ORI2333/Water-meter-quality-inspection/docs/FPGA_ISP_RK3588_WaterMeter_User_Manual.md

# FPGA ISP 涓? RK3588 姘磋〃妫?娴嬩娇鐢ㄦ墜鍐?

鐗堟湰锛歏1.2

鏃ユ湡锛?2026-07-07

## 1. 浣跨敤鑼冨洿

鏈枃妗ｇ敤浜庢寚瀵肩幇鍦鸿繍琛屼互涓嬮摼璺細

```text
SC1336 DVP 鐩告満 -> FPGA ISP -> HDMI 杈撳嚭 -> RK3588 HDMI 閲囬泦 -> YOLO11-pose 鎸囬拡妫?娴?
```

閫傜敤璺緞锛?

| 椤圭洰 | 璺緞 |
| --- | --- |
| FPGA 宸ョ▼ | `fpga/sc1336_hdmi_isp` |
| FPGA 椤跺眰 | `rtl/sc1336_hdmi.sv` |
| FPGA 宸ョ▼鏂囦欢 | `prj/sc1336_hdmi.xpr` |
| RK 浠ｇ爜鐩綍 | `/home/demo/water_meter/code` |
| RK Web 鍚姩鑴氭湰 | `/home/demo/water_meter/run_hdmi_yolo11_pose_web.sh` |
| RK 榛樿妯″瀷 | `/home/demo/water_meter/module/water_meter_yolo11n_pose_fp.rknn` |
| RK 蹇?熸ā鍨? | `/home/demo/water_meter/module/int8_variants/water_meter_yolo11n_pose_int8_headrs_float_normal.rknn` |
| RK Web 椤甸潰 | `http://<RK3588-IP>:6008/` |

## 2. 鍑嗗宸ヤ綔

### 2.1 纭欢杩炴帴

璇风‘璁わ細

1. SC1336 DVP 鐩告満宸茶繛鎺? FPGA銆?
2. FPGA HDMI 杈撳嚭宸茶繛鎺ュ埌 RK3588 HDMI 閲囬泦杈撳叆銆?
3. FPGA UART 璋冭瘯鍙ｅ凡杩炴帴鍒扮數鑴戜覆鍙ｅ伐鍏枫??
4. RK3588 宸插紑鏈猴紝骞惰兘閫氳繃 SSH 璁块棶銆?
5. 鎺ㄨ崘浣跨敤 RK3588 鏈湴 Web 椤甸潰鏄剧ず妫?娴嬬粨鏋滐紝涓嶅啀渚濊禆 Qt 妗岄潰绐楀彛銆?

### 2.2 涓插彛鍙傛暟

FPGA UART 鍙傛暟锛?

| 鍙傛暟 | 鍊? |
| --- | --- |
| 娉㈢壒鐜? | 115200 |
| 鏁版嵁浣? | 8 |
| 鏍￠獙浣? | None |
| 鍋滄浣? | 1 |
| 娴佹帶 | None |

涓插彛宸ュ叿鍙互浣跨敤 MobaXterm銆乆COM銆丼ecureCRT銆丳uTTY 鎴栧叾浠栦覆鍙ｅ姪鎵嬨??

寤鸿涓插彛宸ュ叿鍏抽棴鑷姩杩藉姞鎹㈣锛屽彧鍙戦?佸崟涓瓧绗﹀懡浠ゃ??

### 2.3 RK3588 SSH

榛樿杩炴帴淇℃伅锛?

```bash
ssh root@<RK3588-IP>
```

瀵嗙爜璇蜂娇鐢ㄧ幇鍦鸿澶囧疄闄呴厤缃紝涓嶅缓璁啓鍏ュ叕寮?浠撳簱銆?

## 3. FPGA 宸ョ▼缂栬瘧涓庝笅杞?

### 3.1 鎵撳紑宸ョ▼

Vivado 宸ョ▼鏂囦欢锛?

```text
fpga/sc1336_hdmi_isp\prj\sc1336_hdmi.xpr
```

### 3.2 寤鸿娴佺▼

1. 鎵撳紑 Vivado 宸ョ▼銆?
2. 杩愯缁煎悎銆?
3. 杩愯瀹炵幇銆?
4. 妫?鏌? timing summary銆?
5. 鐢熸垚 bitstream銆?
6. 涓嬭浇鍒? FPGA銆?

濡傛灉瀹炵幇闃舵鍑虹幇 `[Timing 38-282]`锛岄渶瑕佹墦寮? timing summary 鏌ョ湅鍏蜂綋杩濅緥璺緞銆傝嫢涓昏杩濅緥鏉ヨ嚜 ILA銆佽法鏃堕挓璋冭瘯淇″彿鎴栧凡鏈夌害鏉熼棶棰橈紝鐭湡涓婃澘楠岃瘉鍙厛鐪嬪疄闄呯敾闈紱鑻ヨ繚渚嬫潵鑷? HDMI 鍍忕礌閾捐矾銆丏DR 鐢ㄦ埛鎺ュ彛鎴栨柊 ISP 涔樻硶閾捐矾锛屽垯闇?瑕佷紭鍏堝鐞嗐??

褰撳墠鐧藉钩琛′箻娉曞凡缁忓仛杩囨祦姘寸嚎澶勭悊锛岀悊璁轰笂姣旂粍鍚堢骇鑱斾箻娉曟洿瀹规槗杩囨椂搴忋??

## 4. FPGA 鏄剧ず妯″紡娴嬭瘯

涓婃澘鍚庡缓璁寜浠ヤ笅椤哄簭娴嬭瘯銆?

### 4.1 LCD/HDMI 鍩虹娴嬭瘯

鍙戦?侊細

```text
L
```

棰勬湡鐜拌薄锛?

- HDMI 杈撳嚭娴嬭瘯鍥俱??
- 濡傛灉 `L` 閮芥病鏈夋甯告樉绀猴紝浼樺厛妫?鏌? HDMI 杈撳嚭銆佹椂閽熴?佸紩鑴氱害鏉熴?丷K 閲囬泦鑴氭湰銆?

### 4.2 DDR 鍔ㄦ?佹祴璇?

鍙戦?侊細

```text
D
```

棰勬湡鐜拌薄锛?

- 鐢婚潰缁忚繃 DDR 鍐欏叆鍜岃鍑恒??
- 搴旇鑳界湅鍒板姩鎬佹祴璇曞浘銆?
- 鑻? `L` 姝ｅ父鑰? `D` 寮傚父锛屼紭鍏堟鏌? DDR 鍒濆鍖栥?丄XI4銆佸抚缂撳瓨璇诲啓銆?

### 4.3 浼犳劅鍣? RAW 鐏板害

鍙戦?侊細

```text
R
```

鎴栵細

```text
S
```

棰勬湡鐜拌薄锛?

- 鏄剧ず鐩告満 RAW 鐏板害鐢婚潰銆?
- 鐢婚潰鍙兘鍋忕伆銆佹棤褰╄壊锛岃繖鏄甯哥幇璞°??
- 鑻ユ棤鐢婚潰锛屾鏌? SC1336 I2C 鍒濆鍖栥?丏VP PCLK銆乂SYNC銆丠REF銆丏ATA銆?

### 4.4 RGB 鍘婚┈璧涘厠

鍙戦?侊細

```text
I
```

棰勬湡鐜拌薄锛?

- 鍑虹幇褰╄壊鐢婚潰銆?
- 濡傛灉棰滆壊鏄庢樉閿欎贡锛屽彲灏濊瘯 Bayer 鐩镐綅鍛戒护銆?

Bayer 鐩镐綅鍛戒护锛?

```text
0
1
2
3
```

渚濇灏濊瘯锛岄?夋嫨棰滆壊鏈?鑷劧銆佽竟缂樹吉褰╂渶灏戠殑涓?妗ｃ??

### 4.5 鐧藉钩琛′笌浜害

鍙戦?侊細

```text
W
```

棰勬湡鐜拌薄锛?

- 寮?鍚? RGB 鐧藉钩琛°?佸叏灞?澧炵泭鍜屼寒搴﹀亸缃??
- 褰撳墠榛樿鐢婚潰浼氭瘮绾? `I` 妯″紡鏇翠寒銆?

濡傛灉鍚庣画瑕佺敤浜? RK 姘磋〃妫?娴嬶紝鎺ㄨ崘浣跨敤锛?

```text
C
```

`C` 妯″紡鍦? `W` 鍩虹涓婂姞浜嗚竟鐣岃鍓紝鏇撮?傚悎浣滀负褰撳墠闃舵鐨勫僵鑹茶緭鍑哄熀绾裤??

## 5. 涓插彛璋冨弬鍛戒护

### 5.1 妯″紡鍛戒护

| 鍛戒护 | 浣滅敤 |
| --- | --- |
| `L` | LCD/HDMI 娴嬭瘯鍥撅紝缁曡繃 DDR |
| `D` | DDR 鍔ㄦ?佹祴璇曞浘 |
| `X` | DDR 闈欐?? XOR 娴嬭瘯鍥? |
| `G` | DDR 鍥哄畾鐏板害娴嬭瘯鍥? |
| `S` / `R` | 鐩告満 RAW 鐏板害 |
| `I` | RAW 杞? RGB锛屼笉鍔犵櫧骞宠　 |
| `W` | RGB + 鍙皟鐧藉钩琛?/浜害 |
| `C` | RGB + 鍙皟鐧藉钩琛?/浜害 + crop |
| `0` `1` `2` `3` | Bayer 鐩镐綅鍒囨崲 |

### 5.2 鐧藉钩琛′笌浜害鍛戒护

| 鍛戒护 | 浣滅敤 |
| --- | --- |
| `r` | 绾㈣壊澧炵泭澧炲姞 |
| `f` | 绾㈣壊澧炵泭鍑忓皯 |
| `g` | 缁胯壊澧炵泭澧炲姞 |
| `v` | 缁胯壊澧炵泭鍑忓皯 |
| `b` | 钃濊壊澧炵泭澧炲姞 |
| `n` | 钃濊壊澧炵泭鍑忓皯 |
| `a` | 鍏ㄥ眬澧炵泭澧炲姞 |
| `z` | 鍏ㄥ眬澧炵泭鍑忓皯 |
| `+` | 浜害鍋忕疆澧炲姞 |
| `-` | 浜害鍋忕疆鍑忓皯 |
| `w` | 鎭㈠榛樿鐧藉钩琛″拰浜害 |

娉ㄦ剰澶у皬鍐欙細

- `W`锛氳繘鍏ョ櫧骞宠　鏄剧ず妯″紡銆?
- `w`锛氭仮澶嶉粯璁よ皟鍙傚?笺??

## 6. 鎺ㄨ崘璋冨弬娴佺▼

### 6.1 姝ｅ父鍏夌収

1. 鍙戦?? `C`锛岃繘鍏ユ帹鑽愬僵鑹茶緭鍑烘ā寮忋??
2. 濡傛灉鏁翠綋鍋忔殫锛屽厛鍙戦?? `a`锛屾瘡娆″鍔犵害 0.0625x 鍏ㄥ眬澧炵泭銆?
3. 濡傛灉鍙兂鎶珮鏆楅儴锛屽彲鍙戦?? `+` 澧炲姞浜害鍋忕疆銆?
4. 濡傛灉鐢婚潰鍋忕孩锛屽彂閫? `f` 闄嶄綆绾㈣壊澧炵泭銆?
5. 濡傛灉鐢婚潰鍋忚摑锛屽彂閫? `n` 闄嶄綆钃濊壊澧炵泭銆?
6. 濡傛灉鐢婚潰鍋忕豢锛屽彂閫? `v` 闄嶄綆缁胯壊澧炵泭銆?
7. 濡傛灉璋冧贡锛屽彂閫? `w` 鎭㈠榛樿銆?

### 6.2 鏆楀厜鍦烘櫙

鎺ㄨ崘椤哄簭锛?

1. 淇濇寔鏇濆厜闄愬埗锛屼笉寤鸿鐩存帴鏀惧紑闀挎洕鍏夈??
2. 鍏堢敤 `a` 鎻愰珮鍏ㄥ眬澧炵泭銆?
3. 鍐嶇敤 `+` 灏戦噺鎻愰珮浜害鍋忕疆銆?
4. 濡傛灉琛ㄧ洏鐧藉簳杩囨洕锛屽彂閫? `z` 鎴? `-` 鍥為??銆?
5. 蹇呰鏃跺鍔犲閮ㄨˉ鍏夈??

鍒ゆ柇鏍囧噯锛?

- 姘磋〃鍒诲害杈圭紭娓呮櫚銆?
- 鎸囬拡鍜岃儗鏅湁鏄庢樉瀵规瘮銆?
- 鐧藉簳涓嶈繃鏇濇垚涓?鐗囥??
- 鐢婚潰娌℃湁鏄庢樉鎷栧奖鍜屽欢鏃躲??

### 6.3 鐢ㄤ簬 YOLO 妫?娴嬬殑鐢婚潰鏍囧噯

涓嶈鍙寜鑲夌溂鈥滀寒涓嶄寒鈥濆垽鏂?傜敤浜庢娴嬫椂鏇撮噸瑕佺殑鏄細

1. 鎸囬拡灏栫杈圭紭娓呮銆?
2. 灏忚〃鐩樺埢搴﹀拰鎸囬拡鏈夌ǔ瀹氬姣斻??
3. 琛ㄧ洏鍖哄煙涓嶈繃鏇濄??
4. 鏆楅儴鍣０涓嶈杩囬珮銆?
5. 鐢婚潰寤惰繜涓嶈鏄庢樉澧炲姞銆?

## 7. RK3588 Web 妫?娴嬭繍琛?

### 7.1 鍚姩 Web 妫?娴嬫湇鍔?

鍦? RK3588 涓婃墽琛岋細

```bash
cd /home/demo/water_meter
./run_hdmi_yolo11_pose_web.sh
```

鐢佃剳娴忚鍣ㄦ墦寮?锛?

```text
http://<RK3588-IP>:6008/
```

濡傛灉闇?瑕佽皟瑙掑害绋冲畾鍙傛暟锛?

```bash
./run_hdmi_yolo11_pose_web.sh --angle-deadband 3.0 --angle-alpha 0.20 --angle-confirm-frames 4 --turn-deadband 4.0
```

鍙傛暟璇存槑锛?

| 鍙傛暟 | 榛樿鍊? | 浣滅敤 |
| --- | --- | --- |
| `--angle-deadband` | 3.0 | 灏忎簬璇ヨ搴﹀彉鍖栦笉鍒锋柊鏄剧ず |
| `--angle-alpha` | 0.20 | 瓒呰繃姝诲尯鍚庣殑骞虫粦鏇存柊姣斾緥 |
| `--angle-confirm-frames` | 4 | 杩炵画澶氬抚纭鍚庢墠鎺ュ彈瑙掑害鍙樺寲 |
| `--turn-deadband` | 4.0 | 瓒呰繃璇ヨ搴﹀彉鍖栨墠璁″叆绱鍦堟暟 |

璋冨弬寤鸿锛?

| 鐜拌薄 | 璋冩暣 |
| --- | --- |
| 闈欐?佽搴︿粛杞诲井璺冲姩 | 澧炲ぇ `--angle-deadband` 鎴? `--angle-confirm-frames` |
| 鎸囬拡绾垮弽搴斿お鎱? | 澧炲ぇ `--angle-alpha`锛屾垨闄嶄綆 `--angle-confirm-frames` |
| 鍦堟暟闈欐?佹紓绉? | 澧炲ぇ `--turn-deadband` |

### 7.2 Web 椤甸潰鎿嶄綔璇存槑

褰撳墠鎺ㄨ崘浣跨敤鏈湴 Web 椤甸潰锛屼笉鍐嶄娇鐢? Qt 绐楀彛銆傞〉闈㈠湴鍧?锛?

```text
http://<RK3588-IP>:6008/
```

椤甸潰甯冨眬锛?

| 鍖哄煙 | 浣滅敤 |
| --- | --- |
| 宸︿晶瑙嗛鍖? | 鏄剧ず FPGA HDMI 瀹炴椂鐢婚潰鍜屾娴嬭鐩栧眰 |
| 瑙嗛涓嬫柟鍔熻兘鍖? | 鏆傚仠銆佸埛鏂般?佹埅鍥俱?佹樉绀?/闅愯棌鏍囨敞銆佹ā鍨嬫ā寮忓垏鎹€?佽棰戝ぇ灏忋?佹帹娴佹竻鏅板害 |
| 鍙充晶淇℃伅鏍? | 涓ゅ垪鏄剧ず鏍″噯銆佹ā鍨嬭緭鍏ャ?佸洓涓〃鐩樿搴︺?佸湀鏁般?佺粡杩囨按閲忎及绠椼?佹帴鍙ｄ俊鎭? |

瑙嗛鍖哄煙鍐呭彧淇濈暀鐭爣绛撅紝渚嬪 `10^-1`銆乣10^-2`銆傚師濮嬭搴︺?佺ǔ瀹氳搴︺?佸湀鏁般?佹瘡鍦堟按閲忋?佹湰琛ㄤ及绠楁按閲忕瓑璇︾粏鏁版嵁鏀惧湪鍙充晶鈥滆〃鐩樻娴嬪垪琛ㄢ?濅腑锛岄伩鍏嶆枃瀛楅伄鎸℃按琛ㄧ洰鏍囥??

甯哥敤鎸夐挳锛?

| 鎺т欢 | 浣滅敤 |
| --- | --- |
| 鏆傚仠 / 缁х画 | 鏆傚仠鎴栨仮澶? HDMI 閲囬泦鍜屾帹鐞? |
| 鍒锋柊瑙嗛 | 閲嶆柊鎵撳紑 MJPEG 瑙嗛娴? |
| 鎵撳紑鎴浘 | 鎵撳紑褰撳墠 Web 杈撳嚭甯? |
| 鏄剧ず妫?娴嬫爣娉? | 鎺у埗妫?娴嬫銆佷腑蹇冪偣銆佹寚閽堢嚎鍜岀煭鏍囩鏄惁鍙犲姞鍒拌棰? |
| 绮惧害 FP | 鍒囨崲鍒版诞鐐? RKNN 妯″瀷锛屽叧閿偣鏇村噯锛屽抚鐜囪緝浣? |
| 蹇?? INT8 | 鍒囨崲鍒? INT8 hybrid 妯″瀷锛屽抚鐜囨洿楂橈紝鍏抽敭鐐圭簿搴﹀彲鑳戒笅闄? |
| 灏忕獥 / 涓獥 / 褰遍櫌 | 蹇?熻皟鏁磋棰戞樉绀哄尯鍩熷ぇ灏? |

鐢昏川鍜岀爜鐜囨粦鏉★細

| 婊戞潯 | 浣滅敤 | 鏄惁褰卞搷 RK 璐熻浇 |
| --- | --- | --- |
| 瑙嗛妗嗗搴? | 鍙敼鍙樻祻瑙堝櫒涓棰戞鏄剧ず澶у皬 | 鍚? |
| 鎺ㄦ祦瀹藉害 | 鏀瑰彉 Web MJPEG 杈撳嚭瀹藉害 | 浼氬奖鍝嶇紪鐮佽礋杞藉拰缃戠粶娴侀噺 |
| JPEG 璐ㄩ噺 | 鏀瑰彉 MJPEG 鍘嬬缉璐ㄩ噺 | 浼氬奖鍝嶇紪鐮佽礋杞姐?佹竻鏅板害鍜岀爜鐜? |
| 缃戦〉甯х巼 | 鏀瑰彉 Web MJPEG 杈撳嚭甯х巼 | 浼氬奖鍝嶇紪鐮佽礋杞藉拰娴忚鍣ㄦ祦鐣呭害 |

寤鸿榛樿淇濇寔锛?

```text
鎺ㄦ祦瀹藉害 1280
JPEG 璐ㄩ噺 90
缃戦〉甯х巼 12 fps
```

濡傛灉 Web 绔欢杩熷ぇ鎴栫綉缁滀笉绋筹紝鍙紭鍏堥檷浣庣綉椤靛抚鐜囨垨鎺ㄦ祦瀹藉害锛涘鏋滃彧瑙夊緱鐢婚潰澶ぇ锛屼笉瑕侀檷浣庢帹娴佸搴︼紝鐩存帴璋冣?滆棰戞瀹藉害鈥濄??

### 7.3 姘撮噺璁＄畻閫昏緫

鍥涗釜灏忚〃鐩樻槸鍗佽繘鍒惰繘浣嶅叧绯伙紝涓嶈兘鎶婂洓涓〃鐩樼殑鐬椂瑙掑害鎴栧湀鏁扮洿鎺ョ浉鍔犮?傚綋鍓? Web 閲囩敤鈥滃紑濮嬫祴閲忔椂寤虹珛璧风偣锛屼箣鍚庢寜杩炵画杞璁＄畻缁忚繃姘撮噺鈥濈殑鏂瑰紡锛?

```text
鐐瑰嚮鈥滃紑濮嬫祴閲?/娓呴浂鈥?
    -> 娓呴浂鍚勮〃鐩樼疮璁″湀鏁?
    -> 涔嬪悗鎸佺画璺熻釜鎸囬拡瑙掑害鍙樺寲
    -> 鏈〃浼扮畻姘撮噺 = 绱鍦堟暟 x 姣忓湀姘撮噺
```

姣忎釜琛ㄧ洏鐨勬崲绠楀叧绯伙細

| 琛ㄧ洏 | 姣忓皬鏍? | 姣忓湀姘撮噺 |
| --- | --- | --- |
| `10^-1` | 0.1 m鲁 | 1.0 m鲁 |
| `10^-2` | 0.01 m鲁 | 0.1 m鲁 |
| `10^-3` | 0.001 m鲁 | 0.01 m鲁 |
| `10^-4` | 0.0001 m鲁 | 0.001 m鲁 |

褰撳墠椤甸潰涓绘樉绀衡?滄湰娆＄粡杩囨按閲忊?濋粯璁や娇鐢? `10^-4` 琛ㄧ洏浣滀负娴嬮噺鏉ユ簮锛屽洜涓哄畠鏈?鐏垫晱锛岄?傚悎鐭椂闂磋川妫?瑙傚療銆傚彸渚р?滆〃鐩樻娴嬪垪琛ㄢ?濅細鍚屾椂鏄剧ず鍥涗釜琛ㄧ洏鍚勮嚜浼扮畻鐨勬按閲忥紝鍚庣画鍙敤浜庝竴鑷存?ф鏌ャ??

鐜板満鎺ㄨ崘娴佺▼锛?

1. 闇?瑕佸紑濮嬩竴娆¤川妫?鏃讹紝鍏堣姘磋〃闈欐銆?
2. 鐐瑰嚮鈥滃紑濮嬫祴閲?/娓呴浂鈥濄??
3. 寮?濮嬮?氭按鎴栬浆鍔ㄦ寚閽堛??
4. 瑙傚療椤甸潰涓婃柟鈥滄湰娆＄粡杩囨按閲忊?濄??
5. 濡傞渶缁濆璇绘暟锛屽彲鍦ㄢ?滆捣濮?/鍩哄噯 m鲁鈥濅腑濉叆寮?濮嬫椂鐨勬満姊拌鏁帮紝椤甸潰浼氭樉绀衡?滀及绠楁?昏鏁? = 璧峰/鍩哄噯 m鲁 + 鏈缁忚繃姘撮噺鈥濄??

`褰撳墠璁鹃浂浣峘 鏄浂鐐规爣瀹氭搷浣滐紝浼氭妸褰撳墠瑙掑害浣滀负鍚勮〃鐩樼殑 0 浣嶏紱鏅?氭祴閲忓紑濮嬫椂浼樺厛浣跨敤鈥滃紑濮嬫祴閲?/娓呴浂鈥濓紝涓嶈棰戠箒閲嶈闆朵綅銆?

### 7.4 褰撳墠妯″瀷妯″紡

Web 鍚姩鑴氭湰榛樿鍔犺浇绮惧害浼樺厛 FP 妯″瀷锛?

```text
/home/demo/water_meter/module/water_meter_yolo11n_pose_fp.rknn
```

璇ユā寮忓叧閿偣瀹氫綅鏇寸ǔ瀹氾紝閫傚悎璋冭瘯鎸囬拡瑙掑害鍜屾按琛ㄨ鏁帮紝瀹炴椂 HDMI Web 閾捐矾绾? 16 鍒? 18 FPS銆?

濡傛灉瑕佸惎鍔ㄦ椂鐩存帴浣跨敤蹇?? INT8 hybrid 妯″瀷锛?

```bash
cd /home/demo/water_meter
WM_MODEL_MODE=fast ./run_hdmi_yolo11_pose_web.sh
```

蹇?熸ā寮忔ā鍨嬭矾寰勶細

```text
/home/demo/water_meter/module/int8_variants/water_meter_yolo11n_pose_int8_headrs_float_normal.rknn
```

璇ユā寮忓湪宸茬煡楠岃瘉鍥句笂搴旀鍑? 4 涓皬琛ㄧ洏锛屽疄鏃? HDMI Web 閾捐矾绾? 27 鍒? 28 FPS锛屼絾瀹為檯鍏抽敭鐐瑰彲鑳芥瘮 FP 妯″紡鏇村鏄撴姈鍔ㄦ垨鍋忕Щ銆傜幇鍦哄仛瑙掑害鍜屽湀鏁板垽鏂椂锛屼紭鍏堜娇鐢? FP 妯″紡銆?

涔熷彲浠ュ湪 Web 椤甸潰涓偣鍑烩?滅簿搴? FP / 蹇?? INT8鈥濆垏鎹紝鍒囨崲鏃舵湇鍔′細鑷姩閲嶅惎锛岄?氬父绛夊緟绾? 5 绉掑悗鍒锋柊椤甸潰鍗冲彲銆?

### 7.5 鏃犵獥鍙ｆ祴璇? HDMI 杈撳叆

鐢ㄤ簬蹇?熺‘璁? HDMI 娴佹槸鍚﹁兘琚鍙栵細

```bash
cd /home/demo/water_meter/code
python3 -u ./hdmi_yolo11_pose_detect.py \
  --model /home/demo/water_meter/module/int8_variants/water_meter_yolo11n_pose_int8_headrs_float_normal.rknn \
  --device /dev/video73 \
  --width 1280 \
  --height 720 \
  --fps 60 \
  --input-layout nhwc \
  --input-dtype uint8 \
  --color rgb \
  --conf 0.25 \
  --max-frames 30 \
  --no-display \
  --save-output /home/demo/water_meter/pose_hdmi_live_output.jpg
```

杈撳嚭鍥剧墖锛?

```text
/home/demo/water_meter/pose_hdmi_live_output.jpg
```

### 7.6 宸茬煡鍥剧墖娴嬭瘯妯″瀷

鐢ㄤ簬纭妯″瀷鏈韩鏄惁姝ｅ父锛?

```bash
cd /home/demo/water_meter/code
python3 -u ./hdmi_yolo11_pose_detect.py \
  --model /home/demo/water_meter/module/water_meter_yolo11n_pose_fp.rknn \
  --image /home/demo/water_meter/pose_known_val.jpg \
  --save-output /home/demo/water_meter/fp_known.jpg \
  --conf 0.05 \
  --input-layout nhwc \
  --input-dtype float32 \
  --color rgb
```

濡傛灉宸茬煡鍥剧墖鑳芥鍑? 4 涓〃鐩橈紝鑰? HDMI 瀹炴椂娴佹涓嶅嚭锛屼紭鍏堟鏌? FPGA 杈撳嚭鐢婚潰鏄惁鐪熺殑鏄按琛ㄣ?佷寒搴︽槸鍚﹀悎閫傘?佹槸鍚﹀湪娴嬭瘯鍥炬ā寮忋??

## 8. 甯歌闂澶勭悊

### 8.1 FPGA 杈撳嚭浠嶇劧澶粦

澶勭悊椤哄簭锛?

1. 纭褰撳墠鏄? `W` 鎴? `C` 妯″紡銆?
2. 杩炵画鍙戦?佸嚑娆? `a` 澧炲ぇ鍏ㄥ眬澧炵泭銆?
3. 鍐嶅皯閲忓彂閫? `+` 澧炲姞浜害鍋忕疆銆?
4. 濡傛灉鐧藉簳杩囨洕锛屽彂閫? `z` 鎴? `-` 鍥為??銆?
5. 妫?鏌ョ幇鍦鸿ˉ鍏夈??

### 8.2 棰滆壊鏄庢樉涓嶅

澶勭悊椤哄簭锛?

1. 鍦? `I` 妯″紡涓嬪皾璇? `0`銆乣1`銆乣2`銆乣3`锛屾壘鍒版纭? Bayer 鐩镐綅銆?
2. 杩涘叆 `W` 鎴? `C`銆?
3. 鐢? `r/f`銆乣g/v`銆乣b/n` 寰皟棰滆壊銆?
4. 濡傝皟涔憋紝鍙戦?? `w` 鎭㈠榛樿銆?

### 8.3 鏆楀厜涓嬪欢鏃朵弗閲?

鍙兘鍘熷洜锛?

- 鐩告満鏇濆厜鏃堕棿杩囬暱閫犳垚鎷栧奖鍜岃瑙夊欢杩熴??
- 鐜澶殫瀵艰嚧鍥惧儚鍣０鍙樺ぇ锛屾ā鍨嬫娴嬩笉绋冲畾銆?

褰撳墠宸ョ▼宸茬粡闄愬埗鏇濆厜鏃堕棿銆傚缓璁笉瑕侀殢鎰忔斁寮?鏇濆厜涓婇檺锛屽簲閫氳繃鍏ㄥ眬澧炵泭銆佷寒搴︽槧灏勫拰琛ュ厜瑙ｅ喅銆?

### 8.4 RK 鎻愮ず `/dev/video73 is busy`

鍚姩鑴氭湰浼氬皾璇曟潃鎺夊崰鐢ㄨ繘绋嬨?傚鏋滀粛鐒跺け璐ワ紝鍙墜鍔ㄦ墽琛岋細

```bash
fuser /dev/video73
fuser -k /dev/video73
```

鐒跺悗閲嶆柊杩愯 Web锛?

```bash
cd /home/demo/water_meter
./run_hdmi_yolo11_pose_web.sh
```

### 8.5 Web 椤甸潰鎵撲笉寮?鎴栨樉绀烘棫甯冨眬

妫?鏌ワ細

1. 鐢佃剳鍜? RK3588 鏄惁鍦ㄥ悓涓?缃戞銆?
2. RK3588 IP 鏄惁涓虹幇鍦洪厤缃殑 `<RK3588-IP>`銆?
3. 绔彛 `6008` 鏄惁琚剼鏈甯哥洃鍚??
4. Web 杩涚▼鏄惁杩樺湪杩愯銆?

妫?鏌ュ懡浠わ細

```bash
ps -ef | grep hdmi_yolo11_pose_web.py | grep -v grep
ss -lntp | grep 6008
tail -n 80 /home/demo/water_meter/hdmi_yolo11_pose_web.log
```

閲嶆柊鍚姩锛?

```bash
cd /home/demo/water_meter
./run_hdmi_yolo11_pose_web.sh
```

濡傛灉鏈嶅姟姝ｅ父浣嗘祻瑙堝櫒浠嶆樉绀烘棫椤甸潰鎴栨棫鎺т欢锛屾寜 `Ctrl+F5` 寮哄埗鍒锋柊娴忚鍣ㄧ紦瀛樸??

### 8.6 妯″瀷妫?娴嬩笉鍒?

鎸夐『搴忔帓鏌ワ細

1. 鐢ㄥ凡鐭ュ浘鐗囨祴璇曟ā鍨嬨??
2. 淇濆瓨 HDMI 褰撳墠甯э紝鐪嬪疄闄呰緭鍏ユ槸涓嶆槸姘磋〃銆?
3. 纭 FPGA 涓嶆槸 `L`銆乣D`銆乣X`銆乣G` 娴嬭瘯鍥炬ā寮忋??
4. 纭 FPGA 鏄? `C` 妯″紡銆?
5. 璋冩暣浜害鍜岀櫧骞宠　銆?
6. 閫傚綋闄嶄綆 `--conf`锛屼緥濡? `--conf 0.10` 鍋氭帓鏌ャ??

### 8.7 瑙掑害鏄剧ず杞诲井璺冲姩

澧炲ぇ姝诲尯锛?

```bash
./run_hdmi_yolo11_pose_web.sh --angle-deadband 4.0 --angle-alpha 0.20 --angle-confirm-frames 5 --turn-deadband 5.0
```

濡傛灉澧炲ぇ姝诲尯鍚庤搴﹀彉鍖栧弽搴斿お鎱細

```bash
./run_hdmi_yolo11_pose_web.sh --angle-deadband 2.0 --angle-alpha 0.35 --angle-confirm-frames 2 --turn-deadband 3.0
```

## 9. 鐜板満鎺ㄨ崘鍚姩娴佺▼

1. FPGA 涓婄數锛屼笅杞? bitstream銆?
2. 涓插彛鍙戦?? `L`锛岀‘璁? HDMI 鍩虹杈撳嚭銆?
3. 涓插彛鍙戦?? `D`锛岀‘璁? DDR 閾捐矾銆?
4. 涓插彛鍙戦?? `R`锛岀‘璁ょ浉鏈? RAW 鐢婚潰銆?
5. 涓插彛鍙戦?? `I`锛岀‘璁? RGB 鐢婚潰銆?
6. 濡傞鑹查敊涔憋紝灏濊瘯 `0`銆乣1`銆乣2`銆乣3`銆?
7. 涓插彛鍙戦?? `C`锛岃繘鍏ユ帹鑽愭娴嬭緭鍑烘ā寮忋??
8. 鐢? `a/z`銆乣+/-`銆乣r/f`銆乣g/v`銆乣b/n` 璋冩暣鐢婚潰銆?
9. SSH 杩涘叆 RK3588銆?
10. 杩愯 Web 妫?娴嬫湇鍔★細

```bash
cd /home/demo/water_meter
./run_hdmi_yolo11_pose_web.sh --angle-deadband 3.0 --angle-alpha 0.20 --angle-confirm-frames 4 --turn-deadband 4.0
```

11. 鍦ㄧ數鑴戞祻瑙堝櫒鎵撳紑锛?

```text
http://<RK3588-IP>:6008/
```

12. 鐐瑰嚮鈥滃紑濮嬫祴閲?/娓呴浂鈥濓紝浠庡綋鍓嶆椂鍒诲紑濮嬬粺璁＄粡杩囨按閲忋??
13. 瑙傚療妫?娴嬫銆佷腑蹇冪偣銆佹寚閽堝皷绔?佽搴︺?佸湀鏁板拰鈥滄湰娆＄粡杩囨按閲忊?濄?傝棰戝唴鍙樉绀虹煭鏍囩锛岃缁? raw/stable 瑙掑害鍦ㄥ彸渚р?滆〃鐩樻娴嬪垪琛ㄢ?濅腑鏌ョ湅銆?
13. 濡傛灉瑙掑害杞诲井璺冲姩锛屽澶? `--angle-deadband`銆?

## 10. 璋冨弬璁板綍寤鸿

姣忔鎵惧埌杈冨ソ鐨勭幇鍦哄弬鏁帮紝寤鸿璁板綍锛?

| 椤圭洰 | 璁板綍鍐呭 |
| --- | --- |
| 鍏夌収鏉′欢 | 姝ｅ父鍏夈?佹殫鍏夈?佽ˉ鍏変綅缃? |
| FPGA 妯″紡 | 鎺ㄨ崘璁板綍涓? `C` |
| Bayer 鐩镐綅 | `0` / `1` / `2` / `3` |
| 绾㈣壊璋冭妭娆℃暟 | 渚嬪 `r x2` 鎴? `f x1` |
| 缁胯壊璋冭妭娆℃暟 | 渚嬪 `g x1` |
| 钃濊壊璋冭妭娆℃暟 | 渚嬪 `n x2` |
| 鍏ㄥ眬澧炵泭璋冭妭 | 渚嬪 `a x4` |
| 浜害鍋忕疆璋冭妭 | 渚嬪 `+ x2` |
| RK 姝诲尯 | 渚嬪 `1.5 deg` |
| RK 骞虫粦绯绘暟 | 渚嬪 `0.30` |
| 妫?娴嬭〃鐜? | 鏄惁绋冲畾妫?鍑恒?佽搴︽槸鍚︽姈鍔? |

鍚庣画濡傛灉瑕佹妸璋冨弬缁撴灉鍥哄寲鍒? FPGA 榛樿鍊硷紝鍙牴鎹褰曞洖鍐? `sc1336_hdmi.sv` 涓殑榛樿鍙傛暟銆?

## 11. 瀹夊叏娉ㄦ剰浜嬮」

1. 璋冮珮鍏ㄥ眬澧炵泭鍜屼寒搴﹀亸缃細鎻愬崌鏆楅儴锛屼絾涔熶細鏀惧ぇ鍣０銆?
2. 杩囨洕浼氳鎸囬拡杈圭紭涓㈠け锛屽奖鍝? YOLO 鍏抽敭鐐瑰畾浣嶃??
3. 鏆楀厜涓嬩笉瑕佸彧渚濊禆闀挎洕鍏夛紝闀挎洕鍏変細閫犳垚鎷栧奖鍜屽欢鏃躲??
4. RK 渚ц搴︾ǔ瀹氬彧鏄樉绀烘护娉紝涓嶄唬琛ㄧ湡瀹炵墿鐞嗚鏁板凡缁忓畬鎴愩??
5. 鍚庣画鍋氭按琛ㄥ悎鏍煎垽瀹氭椂锛岃繕闇?瑕佸姞鍏ラ浂鐐规爣瀹氥?佸湀鏁扮疮璁°?佽烦鍙樹繚鎶ゅ拰寮傚父妫?娴嬨??
