ORI2333/Water-meter-quality-inspection/fpga/sc1336_hdmi_isp/rtl/lcd_display_test.sv

`timescale 1ns / 1ps
//****************************************VSCODE PLUG-IN**********************************//
//----------------------------------------------------------------------------------------
// IDE :                   VSCODE
// VSCODE plug-in version: Verilog-Hdl-Format-4.3.20260413
// VSCODE plug-in author : Jiang Percy
//----------------------------------------------------------------------------------------
//****************************************Copyright (c)***********************************//
// Copyright(C)            ORI2333
// All rights reserved
// File name:
// Last modified Date:     2026/04/18 16:19:14
// Last Version:           V1.0
// Descriptions:
//----------------------------------------------------------------------------------------
// Created by:             ORI2333
// Created date:           2026/04/18 16:19:14
// mail      :             ori2333.zh@gmail.com
// Version:                V1.0
// TEXT NAME:              lcd_display_test.sv
// PATH:                   fpga/sc1336_hdmi_isp/rtl/lcd_display_test.sv
// Descriptions:
//
//----------------------------------------------------------------------------------------
// source from: https://www.crazyfpga.com
//Author				:		CrazyBingo
//Technology blogs 	: 		www.crazyfpga.com
//****************************************************************************************//

module lcd_display_test#(
    parameter              [  27: 0]      DELAY_TOP                   = 74_250000            
)(
    input                               clk                        ,//system clock
    input                               rst_n                      ,//sync clock
    input                               vsync                      ,//frame sync (0=blanking)

    input                [  11: 0]      lcd_xpos                   ,//lcd horizontal coordinate
    input                [  11: 0]      lcd_ypos                   ,//lcd vertical coordinate
    output reg           [  23: 0]      lcd_data                    //lcd data
);
`include "lcd_para.v"
`define    VGA_HORIZONTAL_COLOR
`define    VGA_VERICAL_COLOR
`define    VGA_GRAY_GRAPH
`define    VGA_GRAFTAL_GRAPH


//-------------------------------------------
`ifdef VGA_HORIZONTAL_COLOR
reg             [  23: 0]      lcd_data0                  ;
always@(posedge clk or negedge rst_n)
    begin
        if(!rst_n)
            lcd_data0 <= 0;
        else
            begin
                if    (lcd_ypos >= 0 && lcd_ypos < (`V_DISP/8)*1)
                    lcd_data0 <= `RED;
                else if(lcd_ypos >= (`V_DISP/8)*1 && lcd_ypos < (`V_DISP/8)*2)
                    lcd_data0 <= `GREEN;
                else if(lcd_ypos >= (`V_DISP/8)*2 && lcd_ypos < (`V_DISP/8)*3)
                    lcd_data0 <= `BLUE;
                else if(lcd_ypos >= (`V_DISP/8)*3 && lcd_ypos < (`V_DISP/8)*4)
                    lcd_data0 <= `WHITE;
                else if(lcd_ypos >= (`V_DISP/8)*4 && lcd_ypos < (`V_DISP/8)*5)
                    lcd_data0 <= `BLACK;
                else if(lcd_ypos >= (`V_DISP/8)*5 && lcd_ypos < (`V_DISP/8)*6)
                    lcd_data0 <= `YELLOW;
                else if(lcd_ypos >= (`V_DISP/8)*6 && lcd_ypos < (`V_DISP/8)*7)
                    lcd_data0 <= `CYAN;
                else                                                // if(lcd_ypos >= (`V_DISP/8)*7 && lcd_ypos < (`V_DISP/8)*8)
                    lcd_data0 <= `ROYAL;
            end
    end
`endif

//-------------------------------------------
`ifdef VGA_VERICAL_COLOR
reg             [  23: 0]      lcd_data1                  ;
always@(posedge clk or negedge rst_n)
    begin
        if(!rst_n)
            lcd_data1 <= 0;
        else
            begin
                if    (lcd_xpos >= 0 && lcd_xpos < (`H_DISP/8)*1)
                    lcd_data1 <= `RED;
                else if(lcd_xpos >= (`H_DISP/8)*1 && lcd_xpos < (`H_DISP/8)*2)
                    lcd_data1 <= `GREEN;
                else if(lcd_xpos >= (`H_DISP/8)*2 && lcd_xpos < (`H_DISP/8)*3)
                    lcd_data1 <= `BLUE;
                else if(lcd_xpos >= (`H_DISP/8)*3 && lcd_xpos < (`H_DISP/8)*4)
                    lcd_data1 <= `WHITE;
                else if(lcd_xpos >= (`H_DISP/8)*4 && lcd_xpos < (`H_DISP/8)*5)
                    lcd_data1 <= `BLACK;
                else if(lcd_xpos >= (`H_DISP/8)*5 && lcd_xpos < (`H_DISP/8)*6)
                    lcd_data1 <= `YELLOW;
                else if(lcd_xpos >= (`H_DISP/8)*6 && lcd_xpos < (`H_DISP/8)*7)
                    lcd_data1 <= `CYAN;
                else                                                // if(lcd_xpos >= (`H_DISP/8)*7 && lcd_xpos < (`H_DISP/8)*8)
                    lcd_data1 <= `ROYAL;
            end
    end
`endif


//-------------------------------------------
`ifdef VGA_GRAFTAL_GRAPH
reg             [  23: 0]      lcd_data2                  ;
always@(posedge clk or negedge rst_n)
    begin
        if(!rst_n)
            lcd_data2 <= 0;
        else
            lcd_data2 <= lcd_xpos * lcd_ypos;
    end
`endif

//-------------------------------------------
`ifdef VGA_GRAY_GRAPH
reg             [  23: 0]      lcd_data3                  ;
always@(posedge clk or negedge rst_n)
    begin
        if(!rst_n)
            lcd_data3 <= 0;
        else
            begin
                if(lcd_ypos < `V_DISP/2)
                    lcd_data3 <= {lcd_ypos[7:0], lcd_ypos[7:0], lcd_ypos[7:0]};
                else
                    lcd_data3 <= {lcd_xpos[7:0], lcd_xpos[7:0], lcd_xpos[7:0]};
            end
    end
`endif

//------------------------------------
//0.5S Delay
reg             [  27: 0]      delay_cnt                  ;
//localparam	DELAT_TOP 50_000000/2
always@(posedge clk or negedge rst_n)
    begin
        if(!rst_n)
            delay_cnt <= 0;
        else
            delay_cnt <= (delay_cnt < DELAY_TOP - 1'b1) ? delay_cnt + 1'b1 : 28'd0;
    end
wire                           delay_0S5_flag           =(delay_cnt== DELAY_TOP - 1'b1) ? 1'b1 : 1'b0;

//------------------------------------
//4 picture cycle cnt 鈥? switch on vsync falling edge (start of blanking)
reg             [   1: 0]      image_cnt;
reg                             switch_pending;
reg                             vsync_d1;
wire                            vsync_falling = vsync_d1 && !vsync;

always@(posedge clk) begin
    vsync_d1 <= vsync;
end

always@(posedge clk or negedge rst_n) begin
    if(!rst_n) begin
        image_cnt      <= 0;
        switch_pending <= 0;
    end else begin
        if (delay_0S5_flag)
            switch_pending <= 1'b1;                  // arm the switch
        if (switch_pending && vsync_falling) begin
            switch_pending <= 1'b0;                  // fire on vsync edge
            image_cnt     <= image_cnt + 1'b1;
        end
    end
end

//------------------------------------
//4 picture cycle
always@(*)
    begin
        case(image_cnt)
            0:    lcd_data <= lcd_data0;
            1:    lcd_data <= lcd_data1;
            2:    lcd_data <= lcd_data2;
            3:    lcd_data <= lcd_data3;
        endcase
    end

endmodule
